OSHChip/oshchip.github.io/README.md

# This is the source for the website OSHChip.ORG
