OSHChip/oshchip.github.io/products/index.md

---
layout: page
title: Products
tags: [Products, oshchip]
modified: 2016-09-28
comments: false
image:
  feature: header.jpg
---

* [OSHChip_V1.0](OSHChip_V1.0_Product.html)
* [OSHChip_CMSIS_DAP_V1.0](OSHChip_CMSIS_DAP_V1.0_Product.html)
* [Programming Cable](Programming_Cable.html)
* [OSHChip SWD 2x2 Adapter](OSHChip_SWD_2x2_Adapter.html)
* [Flip-Pins](Flip-Pins_Product.html)
