OSHChip/oshchip.github.io/products/Flip-Pins_Altium.md

---
layout: page
title: Flip-Pins Library for Altium
excerpt: "Flip-Pins Altium Library"
tags: [Flip-Pins, OSHChip, nRF51822, BLE, Bluetooth Low Energy, Bluetooth Smart]
categories: [Electronics]
comments: false
modified: 2016-09-12
image:
  feature: header.jpg
---

The Altium library for Flip-Pins contains 3 schematic symbols, and for
each symbol, you can choose between two footprints.

* One footprint has the 3D model of just the pins, so you can visualize
  what your board will look like when you are finished

* One footprint has the 3D model that includes the plastic aligner, so
  you can check for clearances around the aligner.

[Altium Schematic Symbols and Footprints](/products/Flip-Pins_Altium_Symbols_and_Footprints_2016_09_12.zip){:target="_blank"}

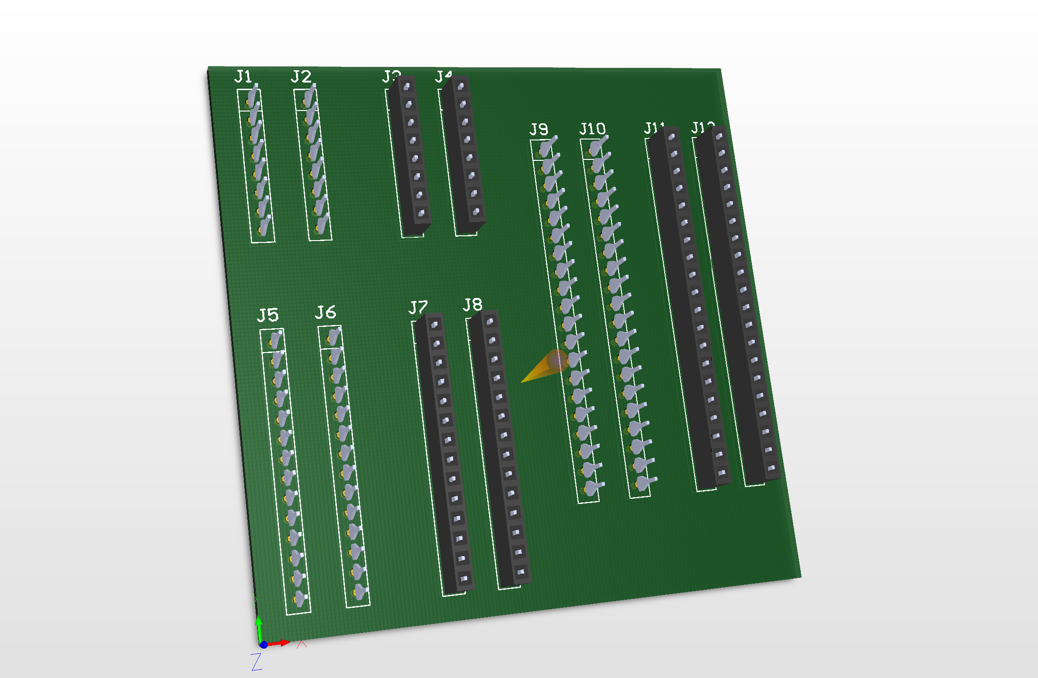
[picture p6: images/PCB_with_all_sizes_Altium.png]


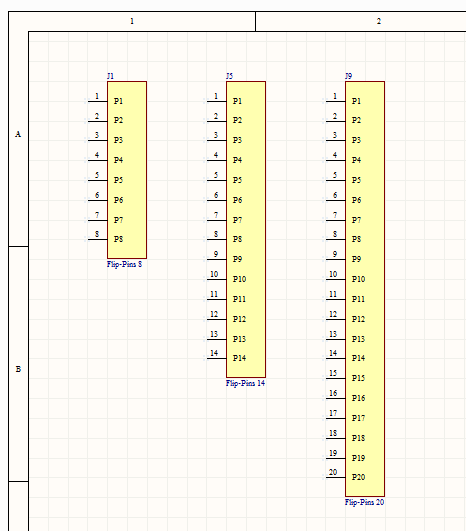
[picture p7: images/Flip-Pins_Altium_Symbols.png]


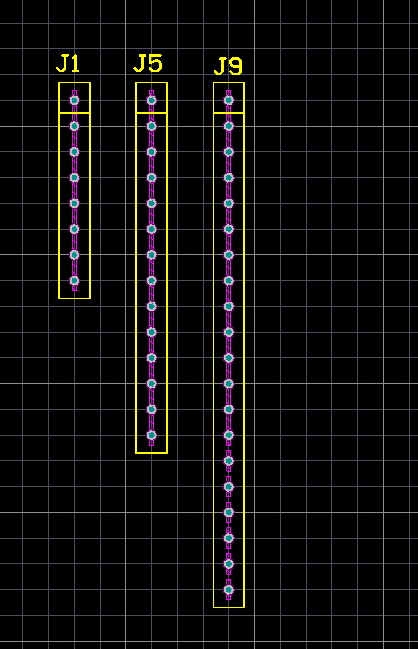
[picture p8: images/Flip-Pins_Altium_Footprints.png]
