OSHChip/oshchip.github.io/products/Flip-Pins_Kicad.md

---
layout: page
title: Flip-Pins Library for Kicad
excerpt: "Flip-Pins Kicad Library"
tags: [Flip-Pins, OSHChip, nRF51822, BLE, Bluetooth Low Energy, Bluetooth Smart]
categories: [Electronics]
comments: false
modified: 2016-09-12
image:
  feature: header.jpg
---

The Kicad library for Flip-Pins contains 3 schematic symbols for the 3
sizes (8, 14, and 20 pins) with 3D models that are only the pins. With
these, you can visualize what your board will look like when you are
finished.

The library also contains 3 schematic symbols that have 3D models that
include the plastic aligner. With these, you can check for clearances
around the aligner.

*Kicad symbols and footprints by Anool of [@WyoLum](https://twitter.com/wyolum){:target="_blank"}*

[Kicad Schematic Symbols and Footprints](/products/Flip-Pins_Kicad_Symbols_and_Footprints_2016_09_12.zip){:target="_blank"}

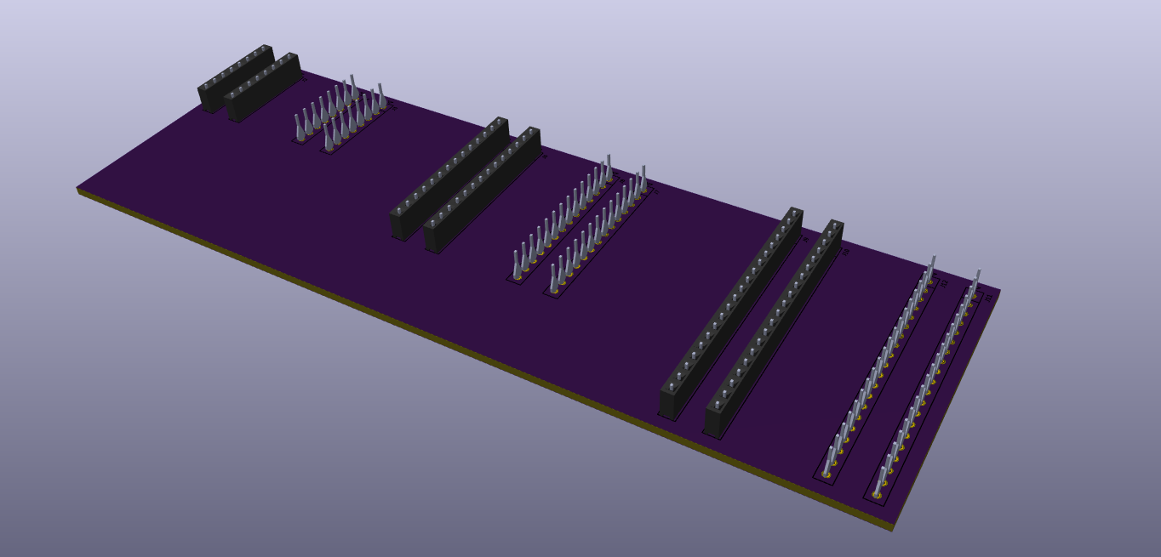
[picture p11: images/PCB_with_all_sizes_3D_Kicad.png]


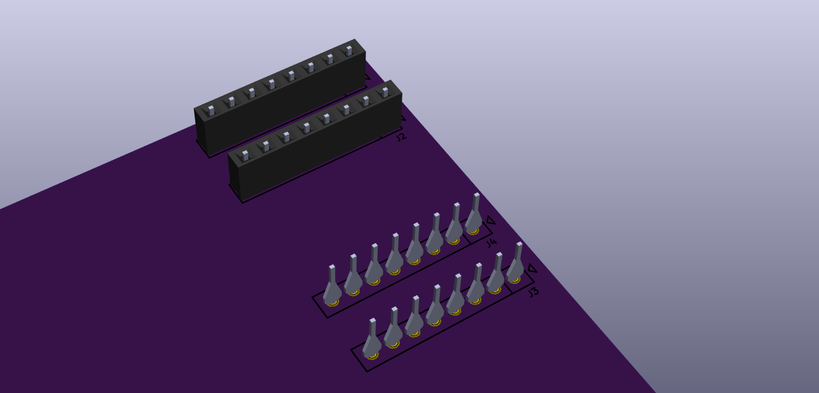
[picture p12: images/PCB_with_just_08_3D_Kicad.png]


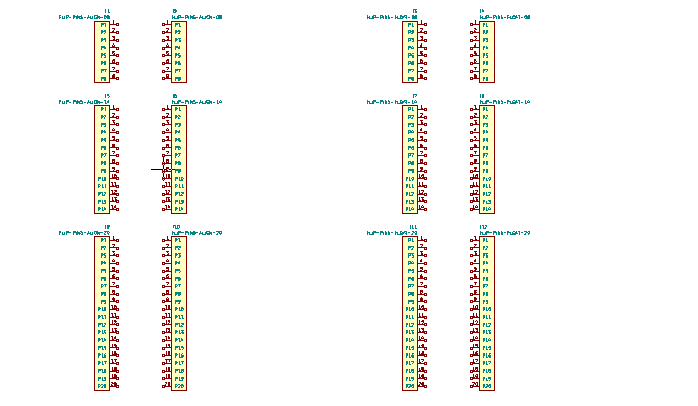
[picture p13: images/Flip-Pins_Kicad_Symbols.png]


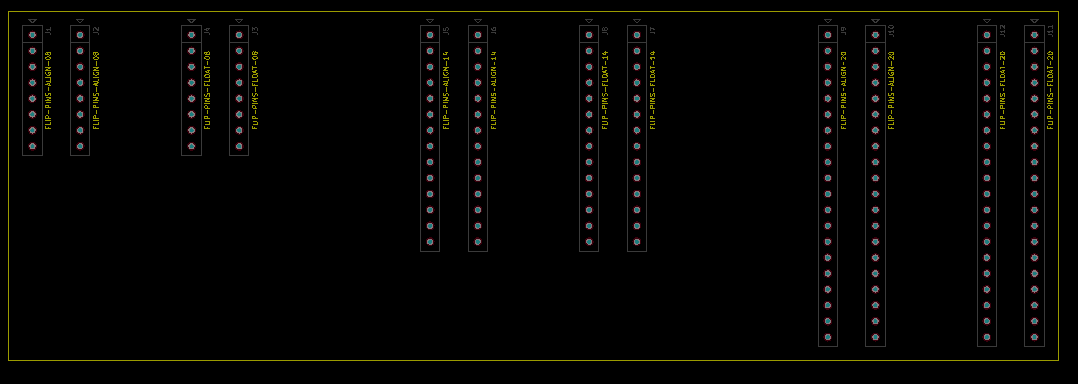
[picture p14: images/Flip-Pins_Kicad_Footprints.png]
