OSHChip/oshchip.github.io/buy/index.md

---
layout: page
title: How to buy OSHChips
tags: [Buy, OSHChip]
modified: 2016-02-11
comments: false
image:
  feature: header.jpg
---

OSHChip is planning to have an online store front but it has not been setup yet.
Until then, sales enquiries can be sent to [philip@oshchip.org](mailto:philip@oshchip.org)

### Typical Orders

Typically you will buy one or more [OSHChips V1.0](/products/OSHChip_V1.0_Product.html)
and one [OSHChip_CMSIS_DAP&nbsp;V1.0](/products/OSHChip_CMSIS_DAP_V1.0_Product.html)
programmer/debugger (if you don't already have one).

Each OSHChip_CMSIS_DAP&nbsp;V1.0 programmer/debugger comes with an
[SWD programming cable](/products/Programming_Cable.html), which is a
10 wire ribbon cable with a 0.050" pitch 2&nbsp;by&nbsp;5
pin female keyed IDC connector at each end, and an [SWD 2x5 to 2x2 Adapter](/products/OSHChip_SWD_2x2_Adapter.html)
designed specifically for OSHChip V1.0.

The OSHChip_CMSIS_DAP&nbsp;V1.0 programmer/debugger connects to your computer via a
USB cable that has a Mini-B plug at the OSHChip_CMSIS_DAP end. The USB
cable is not supplied by OSHChip.

<style type="text/css">
.tgtable1  {border-collapse:collapse;border-spacing:0;border:none;}
.tgtable1 td{font-family:Arial, sans-serif;font-size:18px;padding:10px 5px;border-style:solid;border-width:0px;overflow:hidden;word-break:normal;}
.tgtable1 th{font-family:Arial, sans-serif;font-size:18px;font-weight:normal;padding:10px 5px;border-style:solid;border-width:0px;overflow:hidden;word-break:normal;}
.tgtable1 .tgtable1-x4jz{font-weight:bold;font-family:"Times New Roman", Times, serif !important;;text-align:center}
</style>
<table class="tgtable1">
  <tr>
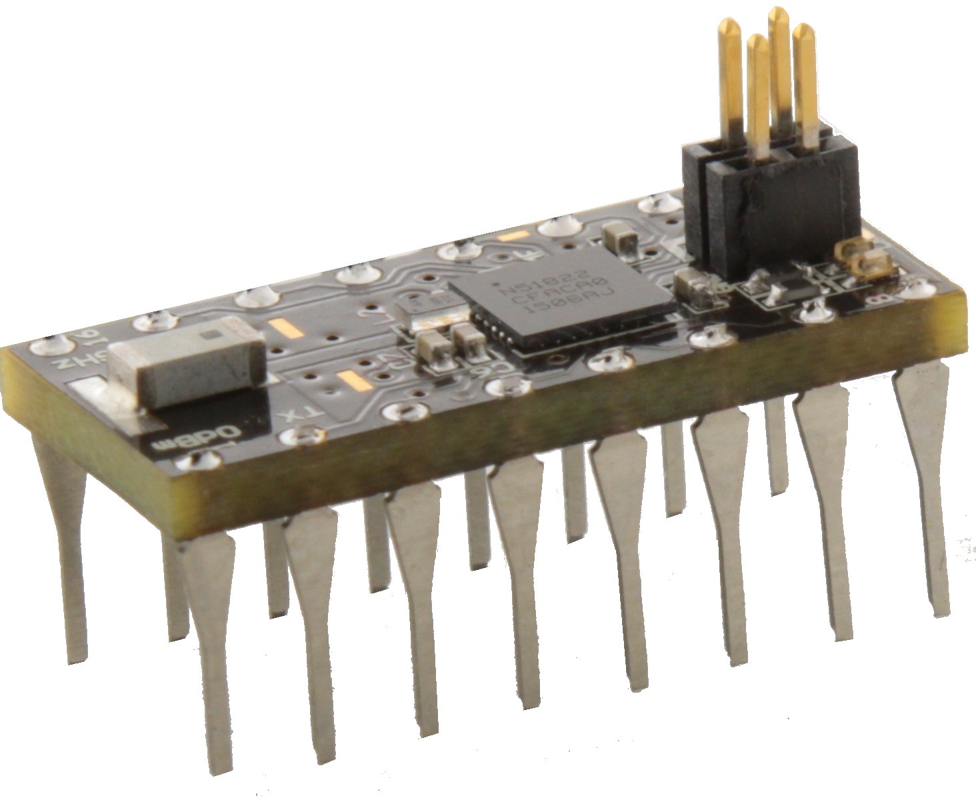
[picture p24: images/OSHChip_on_white_background.jpg]
    <th class="tgtable1-x4jz"></th>
    <th class="tgtable1-x4jz"></th>
  </tr>
  <tr>
    <td class="tgtable1-x4jz">OSHChip&nbsp;V1.0</td>
    <td class="tgtable1-x4jz">OSHChip_CMSIS_DAP&nbsp;V1.0</td>
  </tr>
</table>

<center>
<br>
<b>SWD Ribbon Cable</b>
</center>

<br>

<center>
<br>
<b>SWD 2x5 to 2x2 Adapter</b>
</center>

### Pricing

<style type="text/css">
.tgtable2  {border-collapse:collapse;border-spacing:0;}
.tgtable2 td{font-family:Arial, sans-serif;font-size:14px;padding:10px 5px;border-style:solid;border-width:1px;overflow:hidden;word-break:normal;}
.tgtable2 th{font-family:Arial, sans-serif;font-size:14px;font-weight:normal;padding:10px 5px;border-style:solid;border-width:1px;overflow:hidden;word-break:normal;}
.tgtable2 .tgtable2-xdkn{font-size:16px;font-family:"Times New Roman", Times, serif !important;;text-align:right}
.tgtable2 .tgtable2-gz8f{font-weight:bold;font-size:16px;font-family:"Times New Roman", Times, serif !important;}
.tgtable2 .tgtable2-5iem{font-size:16px;font-family:"Times New Roman", Times, serif !important;}
.tgtable2 .tgtable2-0k7u{font-weight:bold;font-size:16px;font-family:"Times New Roman", Times, serif !important;;text-align:left}
.tgtable2 .tgtable2-lptz{font-size:16px;font-family:"Times New Roman", Times, serif !important;;vertical-align:top}
.tgtable2 .tgtable2-ml68{font-size:16px;font-family:"Times New Roman", Times, serif !important;;text-align:right;vertical-align:top}
</style>
<table class="tgtable2">
  <tr>
    <th class="tgtable2-0k7u">Item</th>
    <th class="tgtable2-gz8f">Price in USD</th>
  </tr>
  <tr>
    <td class="tgtable2-5iem">OSHChip V1.0</td>
    <td class="tgtable2-xdkn">$25.00</td>
  </tr>
  <tr>
    <td class="tgtable2-lptz">OSHChip_CMSIS_DAP V1.0 (including cable and adapter)</td>
    <td class="tgtable2-ml68">$35.00</td>
  </tr>
  <tr>
    <td class="tgtable2-lptz">Shipping &amp; Handling USA</td>
    <td class="tgtable2-ml68">$7.00</td>
  </tr>
  <tr>
    <td class="tgtable2-lptz">Shipping &amp; Handling International</td>
    <td class="tgtable2-ml68">$14.00 - $35.00</td>
  </tr>
</table>

USA Shipping &amp; Handling rates are fixed for orders up to $500. For larger orders, shipping
will be charged at our cost, and will require your approval for your order
to be processed.

International Shipping &amp; Handling rates depends on country and shipping service selected

Californian orders will have 8.75% sales tax added.
