OSHChip/oshchip.github.io/products/Programming_Cable.md

---
layout: page
title: Programming Cable
excerpt: "Product Description"
tags: [SWD, Debug, OSHChip, nRF51822, BLE, Bluetooth Low Energy, Bluetooth Smart]
categories: [Electronics]
comments: false
modified: 2016-02-11
image:
  feature: header.jpg
---

SWD Programming Cable

#### Description

The SWD Programming Cable is a 10 wire ribbon cable with a 0.050” pitch
2&nbsp;by&nbsp;5 pin female keyed IDC connector at each end.

#### Related Information

* [Connecting OSHChip to the programmer/debugger](/docs/OSHChip_Connections.html)
