OSHChip/oshchip.github.io/docs/index.md

---
layout: page
title: Documentation
tags: [docs, oshchip]
modified: 2017-01-01
comments: false
image:
  feature: header.jpg
---

## OSHChip documentation

* Valid links
  * [Schematic for OSHChip V1.0](OSHChip_V1.0___Schematic.PDF){:target="_blank"}
  * [Schematic for OSHChip_CMSIS_DAP V1.0](OSHChip_CMSIS-DAP_V1.0___Schematic_Prints.PDF){:target="_blank"}
  * [nRF51822 Product Specification](http://oshchip.com/downloads/nRF51822_PS_v3.3.pdf){:target="_blank"}
  * [nRF51 Series Reference Manual](http://oshchip.com/downloads/nRF51_Series_Reference_Manual_v3.0.pdf){:target="_blank"}
  * [Connecting OSHChip to the Programmer/Debugger](OSHChip_Connections.html)
  * [Connecting and using the serial data interface](OSHChip_CMSIS_DAP_V1.0_Serial_Data_Interface.html)
  * [Is OSHChip right for me](/docs/Is_OSHChip_right_for_me.html)
  * [Peripheral Pin Assignments for OSHChip](OSHChip_Pin_Assignments.html)
  * [Simple Blinky example using the mbed online compiler](mbed_Blinky.html)
* These links are to pages currently being developed
  * [Getting started with OSHChip](/docs/Getting_started_with_OSHChip.html)
* These links are place holders
  * [Getting started with the Keil Compiler and IDE](Sorry_not_yet_written.html)
  * [A simple example without radio](Sorry_not_yet_written.html)
  * [Simple OSHChip to OSHChip using Gazell](Sorry_not_yet_written.html)
  * [Simple OSHChip to iPhone using BLE](Sorry_not_yet_written.html)
  * [Simple OSHChip to Android Phone using BLE](Sorry_not_yet_written.html)
  * [An introduction to debugging with Keil](Sorry_not_yet_written.html)
  * [Software development using mbed](Sorry_not_yet_written.html)
  * [Software development using Keil](Sorry_not_yet_written.html)
  * [Software development using GCC](Sorry_not_yet_written.html)
