OSHChip/oshchip.github.io/images/default-thumb.png

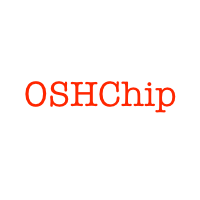
images/default-thumb.png
