OSHChip/oshchip.github.io/images/gallery/OSHChip_on_1_cent_coin.jpg

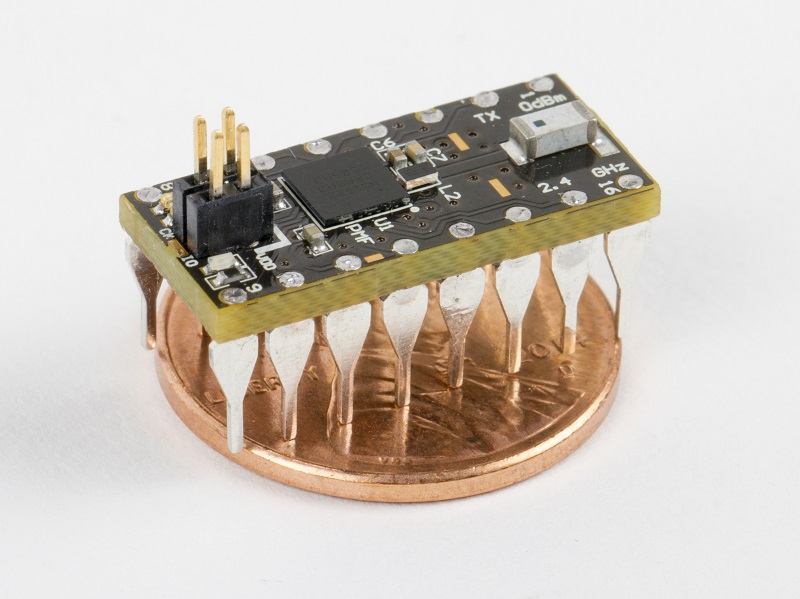
images/gallery/OSHChip_on_1_cent_coin.jpg
