OSHChip/oshchip.github.io/images/gallery/Teensy_3.2_With_OSHChip_Pins_2s.jpg

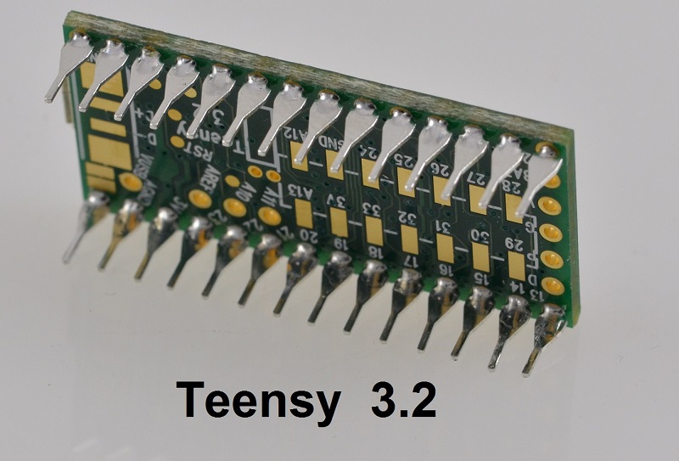
images/gallery/Teensy_3.2_With_OSHChip_Pins_2s.jpg
