OSHChip/oshchip.github.io/images/gallery/Teensy_3.6_on_Breadboard.jpg

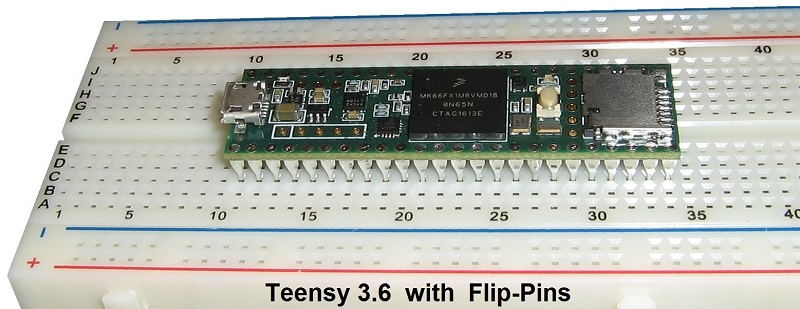
images/gallery/Teensy_3.6_on_Breadboard.jpg
