OSHChip/oshchip.github.io/images/header.jpg

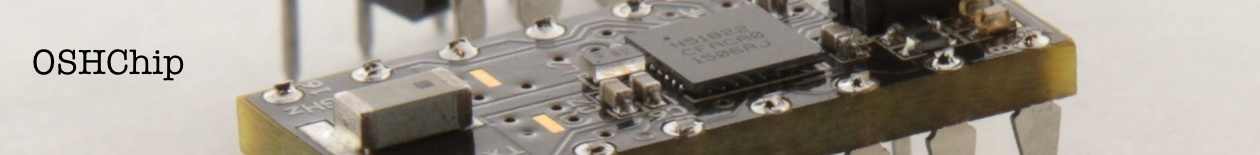
images/header.jpg
