OSHChip/oshchip.github.io/images/IDC_Female_2x5.jpg

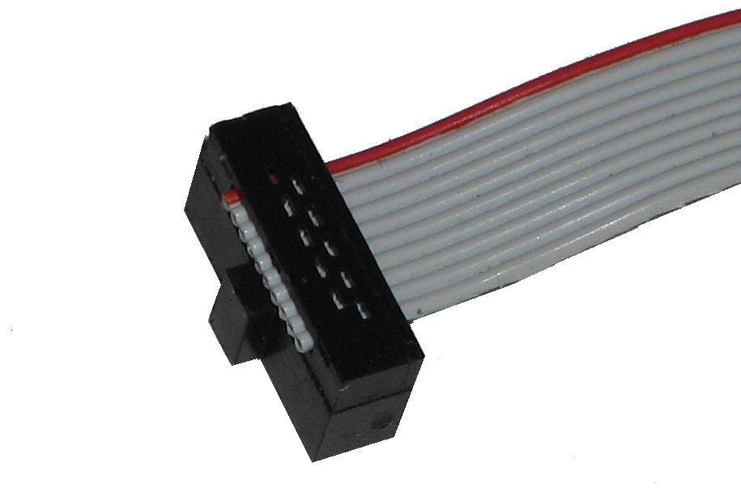
images/IDC_Female_2x5.jpg
