OSHChip/oshchip.github.io/images/nrf51822_Block_Diagram.JPG

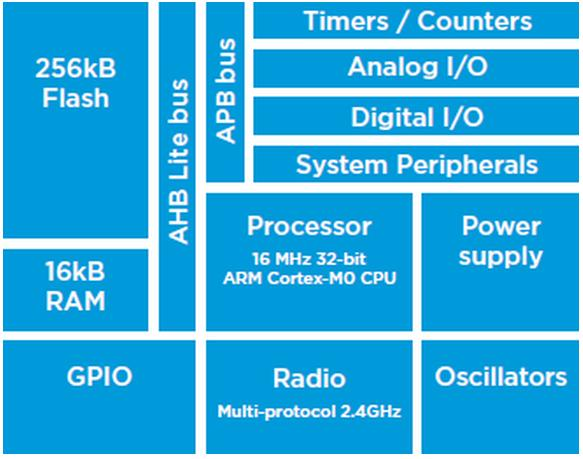
images/nrf51822_Block_Diagram.JPG
