OSHChip/oshchip.github.io/images/nrf51822_Block_Diagram_Detailed.JPG

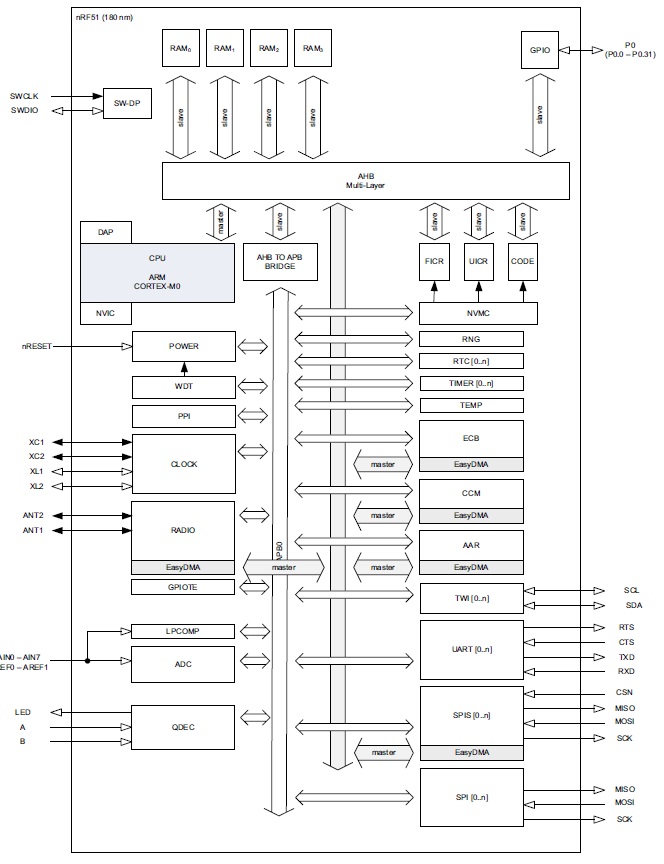
images/nrf51822_Block_Diagram_Detailed.JPG
