OSHChip/oshchip.github.io/images/OSHChip_CMSIS_DAP_and_Cable.JPG

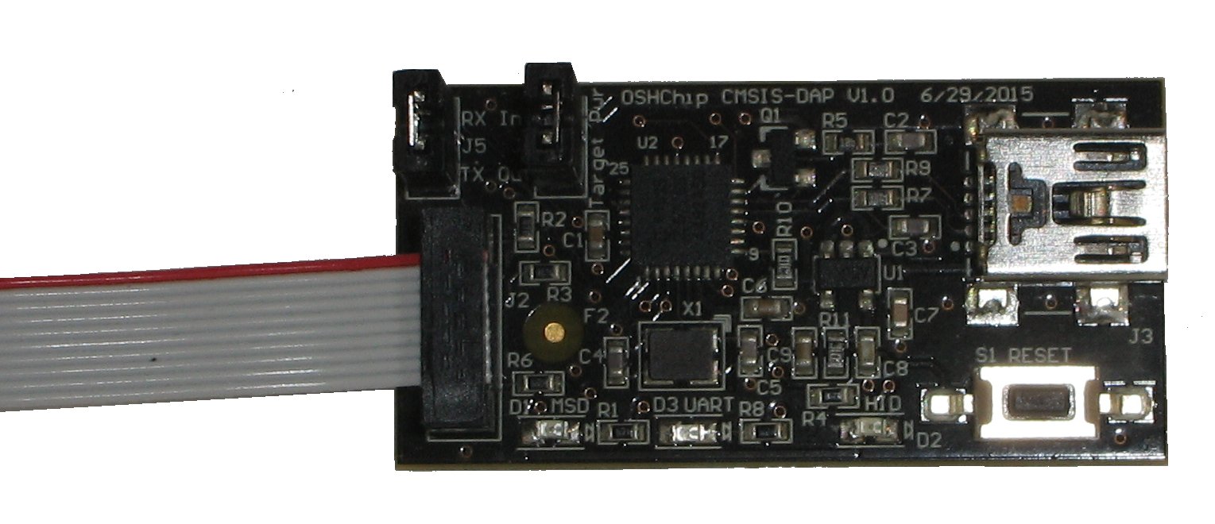
images/OSHChip_CMSIS_DAP_and_Cable.JPG
