OSHChip/oshchip.github.io/images/OSHChip_on_white_background_Width_400.jpg

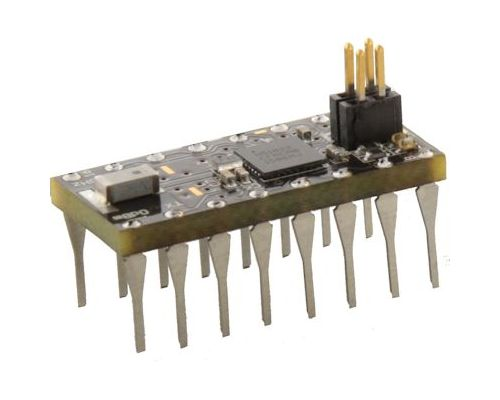
images/OSHChip_on_white_background_Width_400.jpg
