OSHChip/oshchip.github.io/images/portrait.jpg

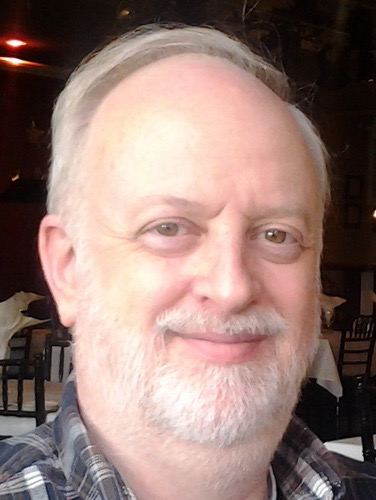
images/portrait.jpg
