OSHChip/oshchip.github.io/images/swd_header.png

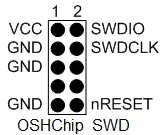
images/swd_header.png
