OSHChip/oshchip.github.io/images/Flip-Pins_Assembly_Parts_to_be_assembled_w600.jpg

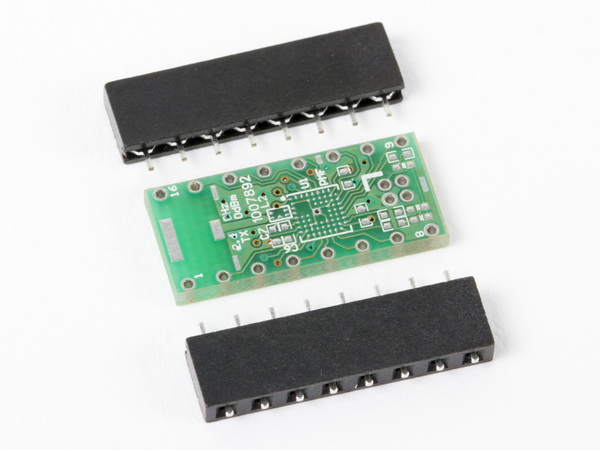
images/Flip-Pins_Assembly_Parts_to_be_assembled_w600.jpg
