OSHChip/oshchip.github.io/docs/Flip-Pins_one_pin_with_aligner.step

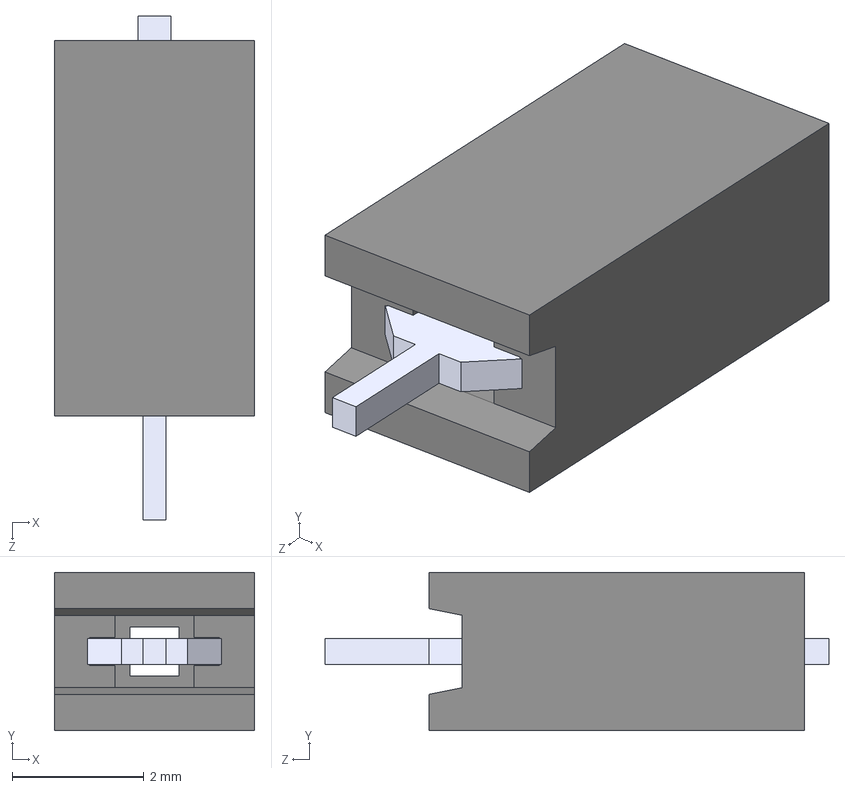
[picture p39: CAD file, 2016-09-13]
docs/Flip-Pins_one_pin_with_aligner.step
3.04 x 2.40 x 7.65 mm
Socket Housing 2.54 Pitch_1 Pin
OSHChip Pin_Stamp
