OSHChip/oshchip.github.io/docs/Flip-Pins_one_pin.step

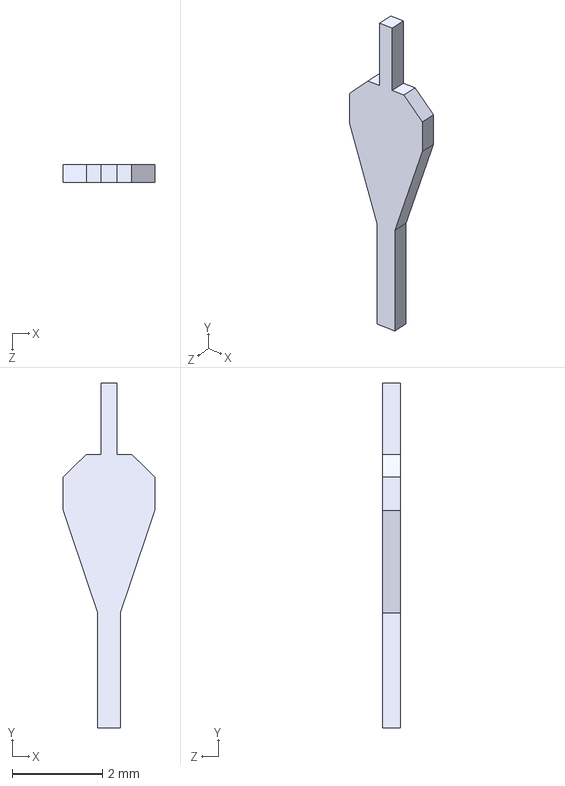
[picture p40: CAD file, 2016-09-13]
docs/Flip-Pins_one_pin.step
2.03 x 7.65 x 0.4 mm
