OSHChip/oshchip.github.io/images/Flip-Pins_Assembly_Ready_for_soldering_w1200.jpg

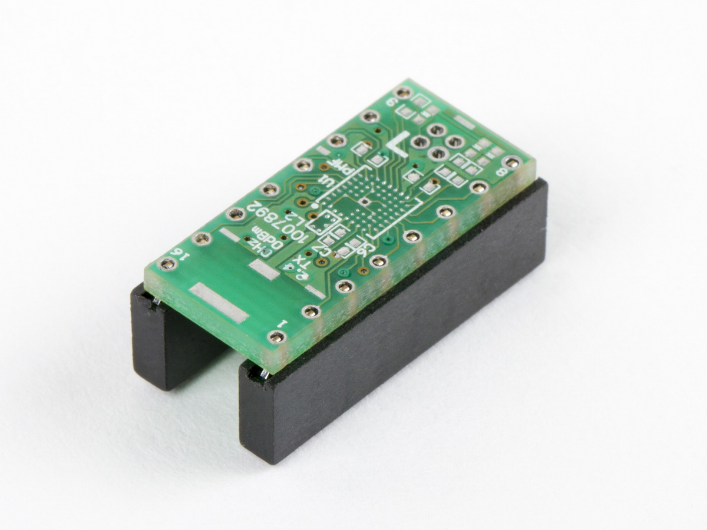
images/Flip-Pins_Assembly_Ready_for_soldering_w1200.jpg
