OSHChip/oshchip.github.io/faq/index.md

---
layout: page
title: Frequently Asked Questions
tags: [FAQ, oshchip]
modified: 2017-01-01
comments: false
image:
  feature: header.jpg
---

* Q: Are the pins on OSHChip custom?
  * A: Yes they are. They were custom designed for OSHChip.
<br><br>
* Q: Can I buy OSChip pins?
  * A: [Yes!](../products/Flip-Pins_Product.html) 
<br><br>
* Q: Which processor is used in OSHChip?
  * A: The Nordic Semiconductors nRF51822-CFAC-A0. Have  
    a look at the banner picture at the top of the page.
<br><br>
* Q: I need a really tiny processor board for a wearable I am  
  designing, can I buy OSHChip without the pins?
  * A: Yes, please contact me directly, see the email link on  
       the left side of the page
