OSHChip/oshchip.github.io/(commit log)

2016-01-02 Delete OSHChip_Black_on_breadboard_4.JPG
    need to update to lower case file extension
2016-02-08 Switch highlighter from pygments to rouge, like github has been telling me
2016-02-09 Switch back to pygments in _config.yml
2016-03-13 Start documentation about Pin Assignments
2016-03-16 Improve documentation about programming connector signals
2016-09-09 Add the Soldering Flip-Pins page and pictures
2016-09-13 Start adding Flip-Pins Library support
    Also add some notes on the Soldering page
2016-09-13 Add the support page for Flip-Pins with Kicad
2016-09-13 Make Step models available
    [Flip-Pins_one_pin.step, Flip-Pins_one_pin_with_aligner.step]
2017-01-05 Update various minor errors, Add Sparkfun, use new kramdown skilz
    Fix links to Nordic PDFs to local copies as they keep changing URLs
    Change several off site URLs to open in a new tab (kramdown skilz)
    Add Dave Jones style OSHW logo
    On Flip-Pins page , show all 3 links for EMSL and Sparkfun , and add
    description about compatibility with IC sockets, which header pins can't
    do.
    On CMSIS-DAP page, add in the infor taken from page on github about the
    need for the serial driver for Windows hosts.
2017-11-28 Improved the description of adding pins to Teensy 3.6
    Improved the description of adding pins to Teensy 3.6 . Also made a minor change to the rework section.
    Did edit directly on GitHub, so need to update my local master copy of this.
2017-12-06 Updated Soldering pins, and yajl-ruby version
    Updated Soldering pins, and update to yajl-ruby version to resolve
    reported security issue
